Kanemusonera/stop-sign-detection/mount/README.md

# Camera mount

SolidWorks source files for the 3D-printed camera mount are **not included** —
add the `.SLDPRT` / `.STL` files here if you still have them.

Two designs were produced:

- **L-bracket** — holds the Pi and Camera Module 3 at a fixed orientation.
- **Tripod** — taller, and allows the ribbon cable to be removed without
  disassembling the mount. This is the design that was printed and used.

Print settings: PETG, 0.1mm layer height, 20–25% infill, supports and brim.

## Design

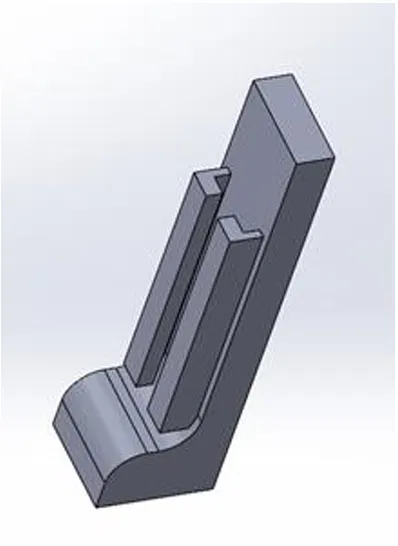
[picture p3: mount/mount-cad.png]
SolidWorks model of the mount


## Printed

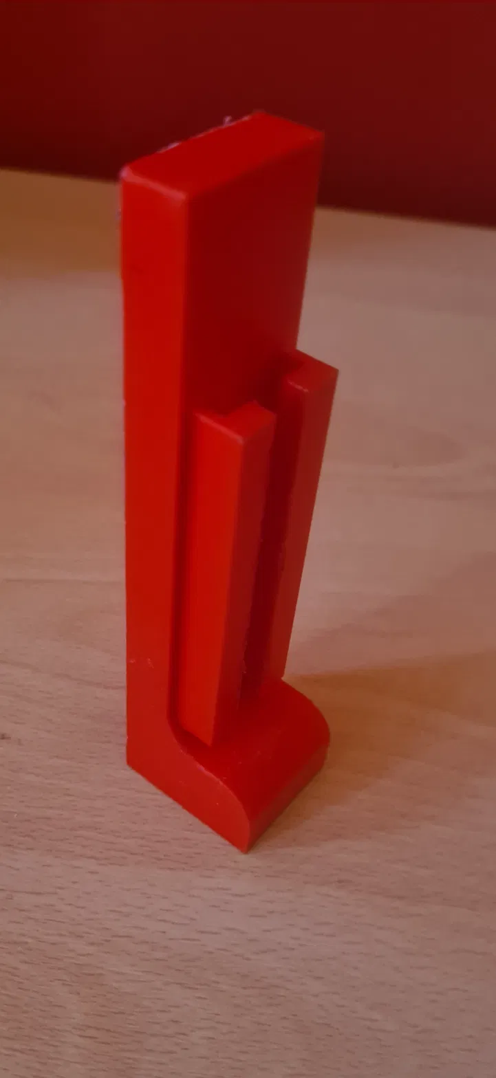
[picture p4: mount/mount-printed.png]
Printed mount in PETG


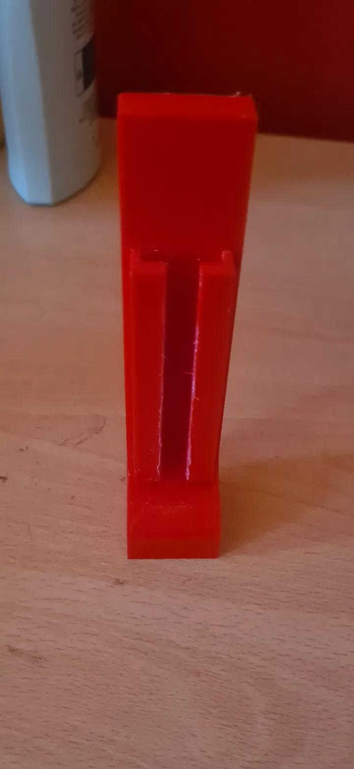
[picture p5: mount/mount-printed-front.png]
Front view showing the ribbon cable channel


See `../docs/hardware.md` for why this mattered more than it might appear.
