Kanemusonera/stop-sign-detection/(commit log)

2026-08-13 Add images to README for system assembly and integration
    Added images of the assembled system and system integration diagram to the README.
2026-08-13 Enhance hardware documentation with camera mount details
    Added images and details about the camera mount and its impact on data quality. Included information on the superseded Pimoroni Explorer pHAT motor control method.
2026-08-13 Enhance README with design and printed images
    Added design and printed images of the mount to README.
2026-08-17 Recover final training script for stop sign detection
    This script is the final training script recovered from the Raspberry Pi's SD card, which produced the model for stop sign detection. It includes updates to paths, data generators, and model saving formats.
2026-08-17 Refactor stop sign detection script for clarity and features
    Revised stop sign detection script with improved structure and functionality. Supports single image, batch processing, and live camera loop, while ensuring compatibility with the Arduino.
2026-08-20 Improve clarity of camera mount testing description
    Revised text to clarify the impact of the camera mount on data quality and removed redundant sentences.
